daneallen/neopixelLanyard/media/v1_PCB.jpg

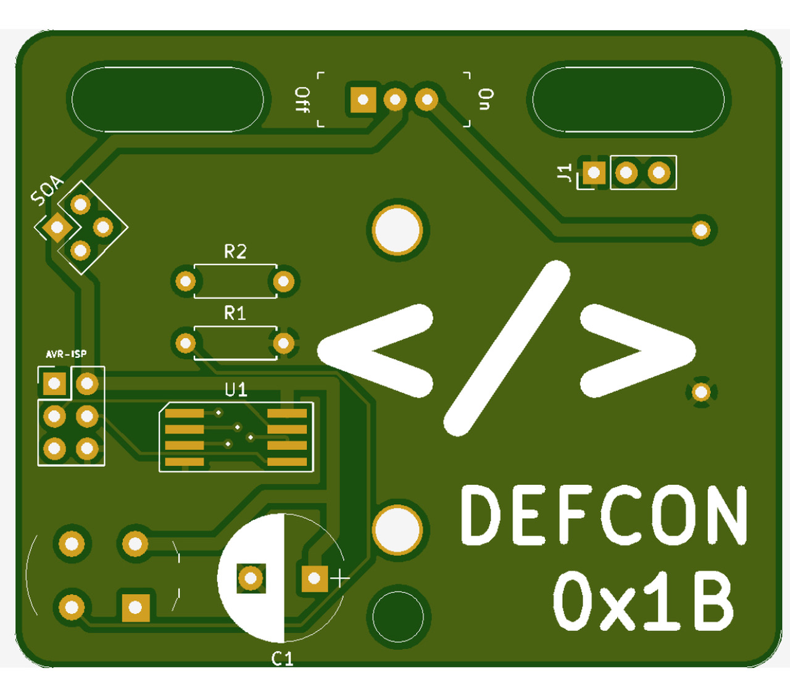
media/v1_PCB.jpg
