daneallen/neopixelLanyard/(commit log)

2019-07-14 PCB Designs
    KiCad files and Gerber files added.
2019-07-14 PCB files moved to new folder
2019-07-14 Create neopixelLanyard.ino
    Arduino source to run the PCB
2019-07-15 BOM Attached
    2 Worksheets in the .xls file
    - Digikey parts and links for populating the PCB
    - Other parts required (i.e. lanyard material, flexible wire, etc.)
    [neopixelLanyard_BOM.xls]
2019-07-20 Add files via upload
    Updated the SAO v1.69 to correctly match the badge footprint.
